alscjfdl33-pixel/biped_bike_runtime/meshes/base_link.STL

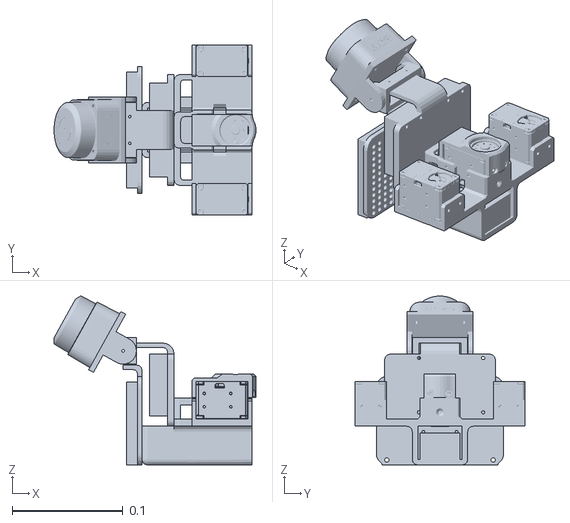
[picture p4: CAD file, 2026-08-25]
meshes/base_link.STL
0.182 x 0.154 x 0.152
