alscjfdl33-pixel/biped_bike_runtime/meshes/r_knee_pitch.STL

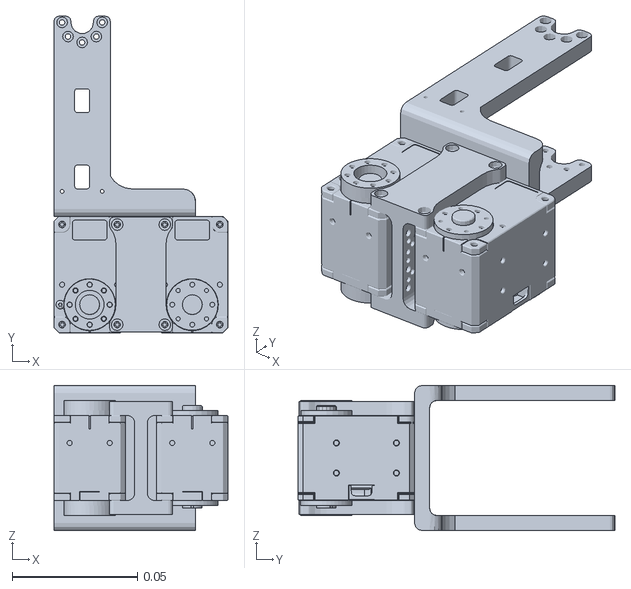
[picture p5: CAD file, 2026-08-25]
meshes/r_knee_pitch.STL
0.0695 x 0.126 x 0.058
