alscjfdl33-pixel/biped_bike_runtime/meshes/arm_wrist_roll.STL

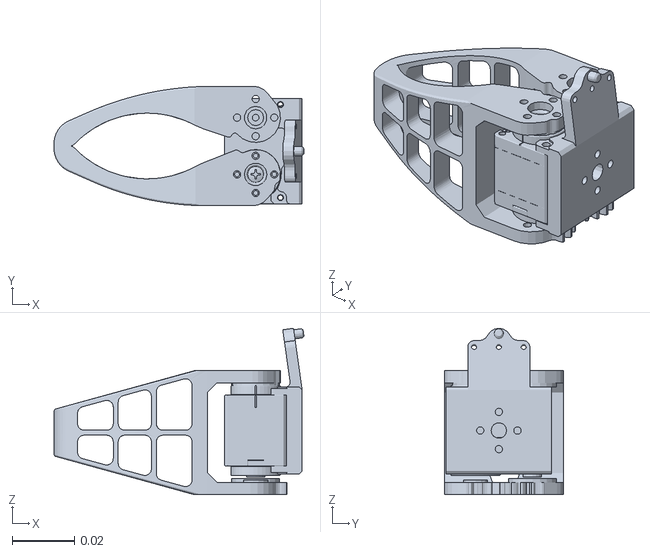
[picture p6: CAD file, 2026-08-25]
meshes/arm_wrist_roll.STL
0.0806 x 0.0385 x 0.0537
