alscjfdl33-pixel/biped_bike_runtime/meshes/l_ankle_pitch.STL

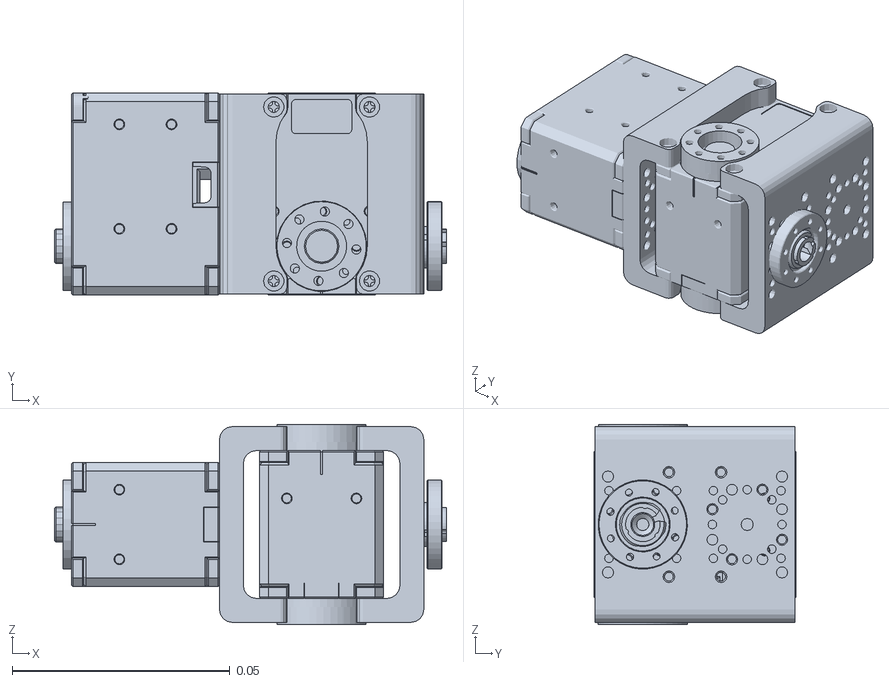
[picture p7: CAD file, 2026-08-25]
meshes/l_ankle_pitch.STL
0.0901 x 0.0465 x 0.046
