alscjfdl33-pixel/biped_bike_runtime/meshes/arm_elbow_pitch.STL

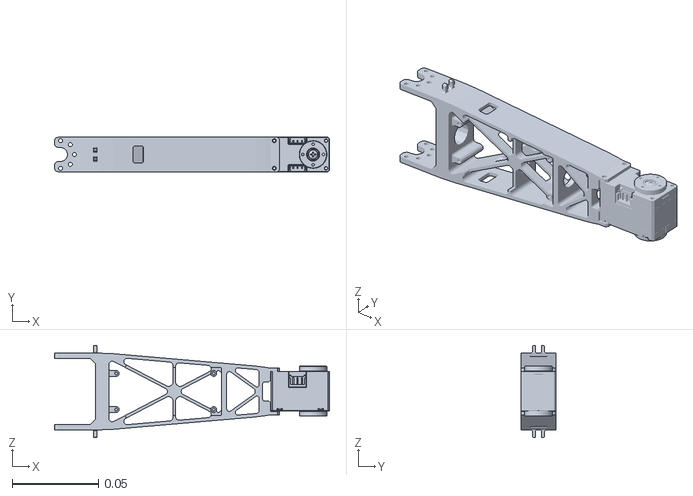
[picture p8: CAD file, 2026-08-25]
meshes/arm_elbow_pitch.STL
0.159 x 0.02 x 0.0535
