alscjfdl33-pixel/biped_bike_runtime/meshes/arm_base_yaw.STL

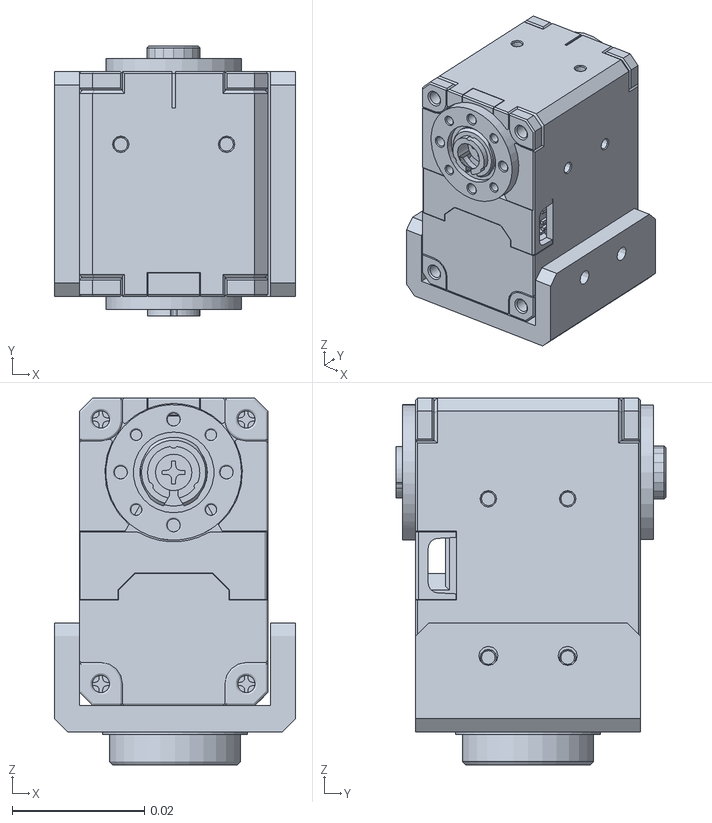
[picture p9: CAD file, 2026-08-25]
meshes/arm_base_yaw.STL
0.0365 x 0.0409 x 0.0555
