alscjfdl33-pixel/biped_bike_runtime/meshes/arm_wrist_pitch.STL

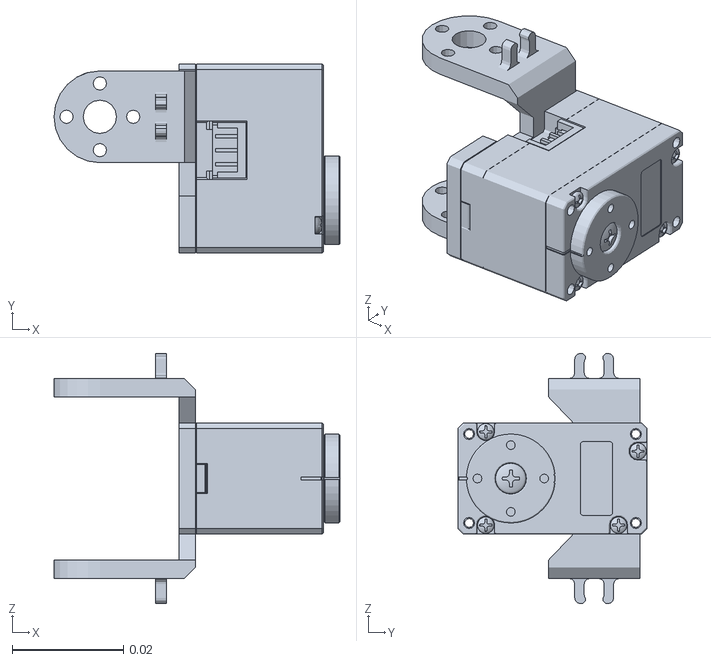
[picture p10: CAD file, 2026-08-25]
meshes/arm_wrist_pitch.STL
0.0515 x 0.034 x 0.045
