alscjfdl33-pixel/biped_bike_runtime/meshes/arm_shoulder_pitch.STL

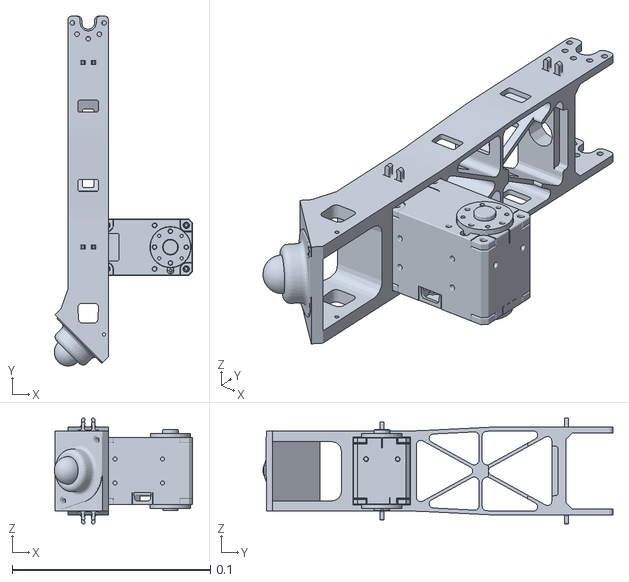
[picture p11: CAD file, 2026-08-25]
meshes/arm_shoulder_pitch.STL
0.0699 x 0.177 x 0.0535
