alscjfdl33-pixel/biped_bike_runtime/meshes/r_hip_yaw.STL

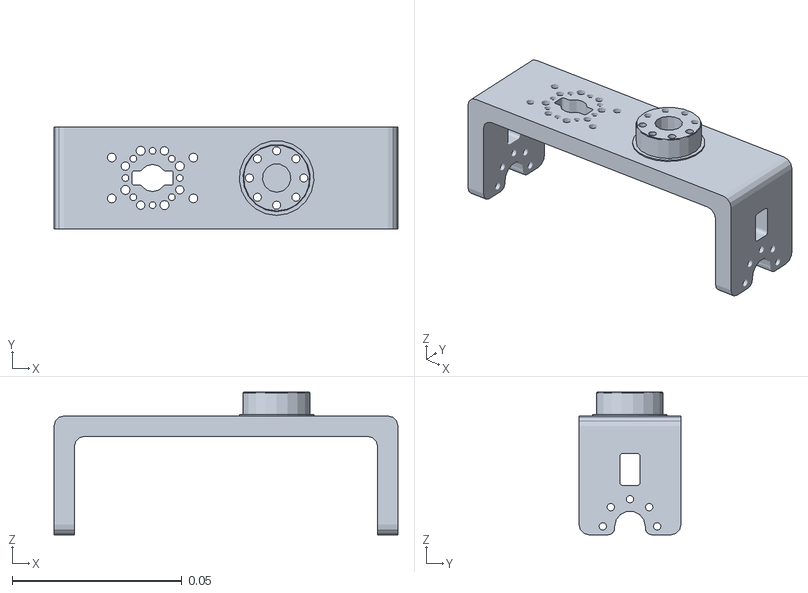
[picture p12: CAD file, 2026-08-25]
meshes/r_hip_yaw.STL
0.101 x 0.03 x 0.042
