alscjfdl33-pixel/biped_bike_runtime/meshes/l_hip_pitch.STL

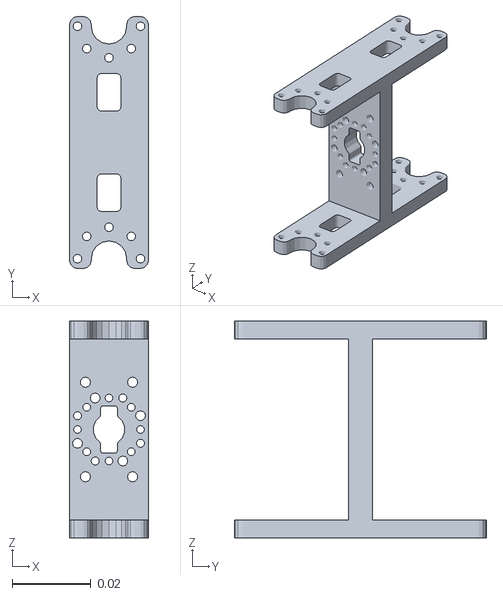
[picture p13: CAD file, 2026-08-25]
meshes/l_hip_pitch.STL
0.02 x 0.064 x 0.055
