alscjfdl33-pixel/biped_bike_runtime/meshes/r_foot_roll.STL

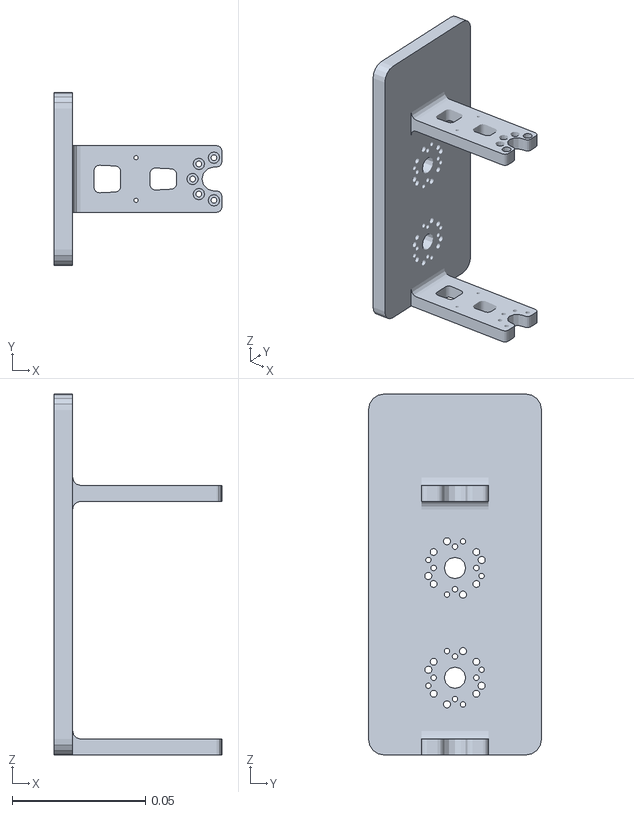
[picture p14: CAD file, 2026-08-25]
meshes/r_foot_roll.STL
0.063 x 0.065 x 0.135
