alscjfdl33-pixel/biped_bike_runtime/meshes/l_knee_pitch_wheel.STL

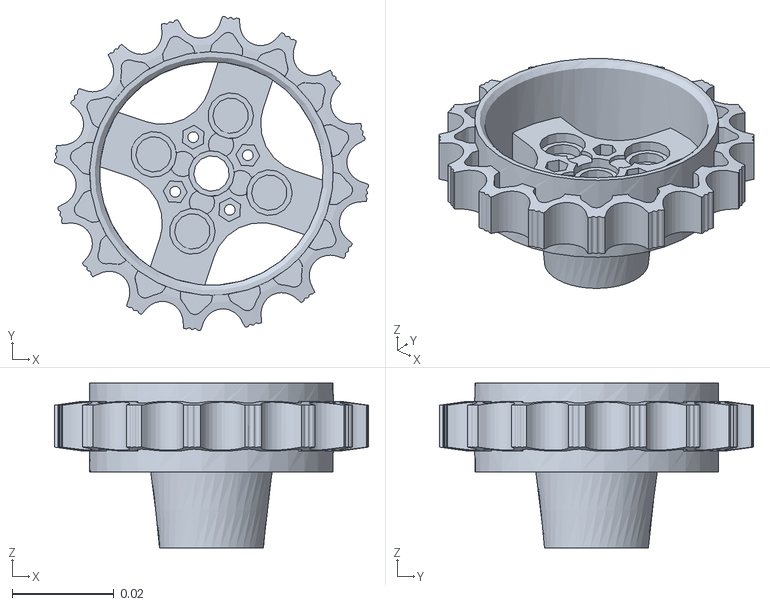
[picture p15: CAD file, 2026-08-25]
meshes/l_knee_pitch_wheel.STL
0.0619 x 0.0619 x 0.0325
