alscjfdl33-pixel/biped_bike_runtime/(list of files, cad)

Other CAD files:
meshes/r_hip_roll.STL
meshes/l_knee_pitch.STL
meshes/l_hip_roll.STL
meshes/r_ankle_pitch.STL
meshes/r_hip_pitch.STL
meshes/l_hip_yaw.STL
meshes/l_foot_roll.STL
meshes/r_knee_pitch_wheel.STL
solidworks_export/meshes/l_foot_roll.STL
solidworks_export/meshes/l_hip_roll.STL
solidworks_export/meshes/l_hip_yaw.STL
solidworks_export/meshes/l_knee_pitch.STL
solidworks_export/meshes/r_ankle_pitch.STL
solidworks_export/meshes/r_hip_pitch.STL
solidworks_export/meshes/r_hip_roll.STL
solidworks_export/meshes/r_knee_pitch_wheel.STL
