alscjfdl33-pixel/biped_bike_runtime/scripts/dxl_joint_state_bridge.py

#!/usr/bin/env python3
import csv
import datetime as dt
import math
import os
import struct
from typing import Dict, List, Optional, Tuple

import rclpy
import yaml
from ament_index_python.packages import get_package_share_directory
from rclpy.node import Node
from sensor_msgs.msg import Imu, JointState
from std_msgs.msg import Float64MultiArray
from trajectory_msgs.msg import JointTrajectory

try:
    from dynamixel_sdk import COMM_SUCCESS, GroupSyncRead, GroupSyncWrite, PacketHandler, PortHandler
except ImportError:
    COMM_SUCCESS = None
    GroupSyncRead = None
    GroupSyncWrite = None
    PacketHandler = None
    PortHandler = None


ADDR_OPERATING_MODE = 11
ADDR_PWM_LIMIT = 36
ADDR_TORQUE_ENABLE = 64
ADDR_HARDWARE_ERROR_STATUS = 70
ADDR_POSITION_D_GAIN = 80
ADDR_POSITION_I_GAIN = 82
ADDR_POSITION_P_GAIN = 84
ADDR_GOAL_VELOCITY = 104
ADDR_PROFILE_ACCELERATION = 108
ADDR_PROFILE_VELOCITY = 112
ADDR_GOAL_POSITION = 116
ADDR_PRESENT_PWM = 124
ADDR_PRESENT_LOAD = 126
ADDR_PRESENT_VELOCITY = 128
ADDR_PRESENT_POSITION = 132
ADDR_PRESENT_INPUT_VOLTAGE = 144
ADDR_PRESENT_TEMPERATURE = 146
LEN_GOAL_POSITION = 4
LEN_GOAL_VELOCITY = 4
LEN_TELEMETRY_BLOCK = 23
ADDR_OPENCR_IMU_BLOCK = 100
LEN_OPENCR_IMU_BLOCK = 68
STANDARD_GRAVITY = 9.80665
TORQUE_DISABLE = 0
TORQUE_ENABLE = 1
READY_HIP_PITCH_RAD = 0.0
READY_KNEE_PITCH_RAD = -0.30
READY_ANKLE_FORWARD_OFFSET_RAD = 0.174533
READY_ANKLE_PITCH_RAD = 0.15 + READY_ANKLE_FORWARD_OFFSET_RAD
HARDWARE_ERROR_BITS = {
    0: "input_voltage",
    2: "overheating",
    3: "motor_encoder",
    4: "electrical_shock",
    5: "overload",
}


Trajectory = List[Tuple[float, Dict[str, float]]]


def interpolate_trajectory(
    start_positions: Dict[str, float],
    trajectory: Trajectory,
    elapsed: float,
) -> Tuple[Dict[str, float], bool]:
    """Linearly sample a trajectory, using the current pose as the t=0 point."""
    if not trajectory:
        return dict(start_positions), True

    if elapsed >= trajectory[-1][0]:
        return dict(trajectory[-1][1]), True

    previous_time = 0.0
    previous_positions = start_positions
    for next_time, next_positions in trajectory:
        if elapsed <= next_time:
            duration = next_time - previous_time
            alpha = 1.0 if duration <= 0.0 else (elapsed - previous_time) / duration
            alpha = max(0.0, min(1.0, alpha))
            sampled = {
                name: previous_positions[name]
                + alpha * (next_positions[name] - previous_positions[name])
                for name in next_positions
            }
            return sampled, False
        previous_time = next_time
        previous_positions = next_positions

    return dict(trajectory[-1][1]), True


class MotorConfig:
    def __init__(self, data: dict, tick_per_rad: float):
        self.id = int(data["id"])
        self.joint_name = data["joint_name"]
        self.control_mode = data["control_mode"]
        self.operating_mode = int(data["operating_mode"])
        self.center_tick = int(data.get("center_tick", 2048))
        self.direction = int(data.get("direction", 1))
        self.active = bool(data.get("active", True))
        self.tick_per_rad = tick_per_rad
        self.min_position_rad = float(data.get("min_position_rad", -math.inf))
        self.max_position_rad = float(data.get("max_position_rad", math.inf))
        max_abs_position_rad = data.get("max_abs_position_rad")
        self.max_abs_position_rad = (
            None if max_abs_position_rad is None else float(max_abs_position_rad)
        )
        self.pwm_limit = data.get("pwm_limit")
        self.position_p_gain = data.get("position_p_gain")
        self.position_i_gain = data.get("position_i_gain")
        self.position_d_gain = data.get("position_d_gain")
        self.profile_acceleration = data.get("profile_acceleration")
        self.profile_velocity = data.get("profile_velocity")

    def position_to_tick(self, position_rad: float) -> int:
        tick = self.center_tick + self.direction * position_rad * self.tick_per_rad
        return int(round(max(0, min(4095, tick))))

    def tick_to_position(self, tick: int) -> float:
        return (tick - self.center_tick) / (self.direction * self.tick_per_rad)

    def position_in_range(self, position_rad: float) -> bool:
        return self.min_position_rad <= position_rad <= self.max_position_rad

    def command_abs_limit(self, default_limit: float) -> float:
        if self.max_abs_position_rad is not None:
            return self.max_abs_position_rad
        return default_limit

    def velocity_to_raw(self, velocity_rad_s: float, raw_per_rad_s: float) -> int:
        raw = round(self.direction * velocity_rad_s * raw_per_rad_s)
        return max(-(2**31), min(2**31 - 1, raw))


class DxlJointStateBridge(Node):
    def __init__(self):
        super().__init__("dxl_joint_state_bridge")

        self.declare_parameter("config_path", "")
        self.declare_parameter("torque_on_start", True)
        self.declare_parameter("torque_off_on_shutdown", True)
        self.declare_parameter("center_on_start", False)
        self.declare_parameter("startup_ready_posture_on_start", False)
        self.declare_parameter("startup_forward_lean_deg", 0.0)
        self.declare_parameter("startup_shoulder_pitch_deg", -70.0)
        self.declare_parameter("max_abs_position_rad", 0.35)
        self.declare_parameter("min_tick_change", 2)
        self.declare_parameter("log_joint_states", True)
        self.declare_parameter("enable_joint_state_commands", True)
        self.declare_parameter("enable_trajectory_commands", True)
        self.declare_parameter("enable_velocity_commands", True)
        self.declare_parameter(
            "trajectory_topic", "/joint_trajectory_controller/joint_trajectory"
        )
        self.declare_parameter(
            "velocity_topic", "/wheel_velocity_controller/commands"
        )
        self.declare_parameter("max_wheel_velocity_rad_s", 2.0)
        self.declare_parameter("wheel_command_timeout_sec", 0.5)
        self.declare_parameter("log_telemetry", False)
        self.declare_parameter("telemetry_log_path", "")
        self.declare_parameter("telemetry_rate_hz", 5.0)
        self.declare_parameter("telemetry_duration_sec", 10.0)
        self.declare_parameter("telemetry_motor_ids", "")
        self.declare_parameter("publish_present_joint_states", False)
        self.declare_parameter("present_joint_state_topic", "/joint_states")
        self.declare_parameter("present_joint_state_rate_hz", 15.0)
        self.declare_parameter("present_joint_state_motor_ids", "")
        self.declare_parameter("enable_opencr_imu", False)
        self.declare_parameter("opencr_imu_id", 200)
        self.declare_parameter("opencr_imu_topic", "/opencr/imu")
        self.declare_parameter("opencr_imu_frame_id", "body_link")
        self.declare_parameter("opencr_imu_rate_hz", 30.0)

        if PacketHandler is None or PortHandler is None:
            raise RuntimeError(
                "dynamixel_sdk is not installed. Install the ROS/Python Dynamixel SDK first."
            )

        config_path = self.get_parameter("config_path").get_parameter_value().string_value
        if not config_path:
            pkg_share = get_package_share_directory("biped_bike_runtime")
            config_path = os.path.join(pkg_share, "config", "dynamixel_hardware.yaml")

        self.config = self._load_config(config_path)
        self.port_handler = PortHandler(self.config["bus"]["device"])
        self.packet_handler = PacketHandler(float(self.config["bus"]["protocol_version"]))
        self.group_sync_write = GroupSyncWrite(
            self.port_handler,
            self.packet_handler,
            ADDR_GOAL_POSITION,
            LEN_GOAL_POSITION,
        )
        self.group_sync_write_velocity = GroupSyncWrite(
            self.port_handler,
            self.packet_handler,
            ADDR_GOAL_VELOCITY,
            LEN_GOAL_VELOCITY,
        )
        self.group_sync_read = None
        self.last_goal_ticks: Dict[int, int] = {}
        self.last_goal_velocities: Dict[int, int] = {}
        self.last_velocity_command_time = None
        self.velocity_watchdog_stopped = True
        self.received_joint_states = False
        self.active_trajectory: Trajectory = []
        self.trajectory_start_positions: Dict[str, float] = {}
        self.trajectory_start_time = None
        self.telemetry_file = None
        self.telemetry_writer = None
        self.telemetry_start_time = None
        self.telemetry_duration_sec = 0.0
        self.telemetry_motors = []
        self.opencr_imu_warned = False
        self._destroying = False

        self.max_abs_position_rad = (
            self.get_parameter("max_abs_position_rad").get_parameter_value().double_value
        )
        self.min_tick_change = (
            self.get_parameter("min_tick_change").get_parameter_value().integer_value
        )
        self.max_wheel_velocity_rad_s = float(
            self.get_parameter("max_wheel_velocity_rad_s").value
        )
        self.wheel_command_timeout_sec = float(
            self.get_parameter("wheel_command_timeout_sec").value
        )
        self.velocity_raw_per_rad_s = float(
            self.config["conversion"]["velocity_raw_per_rad_per_sec"]
        )

        self.all_motors = self._load_active_motors()
        self.position_motors = [
            motor for motor in self.all_motors if motor.control_mode == "position"
        ]
        self.velocity_motors = [
            motor for motor in self.all_motors if motor.control_mode == "velocity"
        ]
        self.joint_to_motor = {motor.joint_name: motor for motor in self.position_motors}

        self._open_bus()
        self._configure_motors(
            torque_on_start=self.get_parameter("torque_on_start").value
        )
        if self.get_parameter("center_on_start").value:
            self._center_position_motors()
        if self.get_parameter("startup_ready_posture_on_start").value:
            self._send_startup_ready_posture()

        publish_present_joint_states = bool(
            self.get_parameter("publish_present_joint_states").value
        )
        present_joint_state_topic = self.get_parameter("present_joint_state_topic").value
        if publish_present_joint_states:
            self._setup_present_joint_state_publisher(present_joint_state_topic)

        joint_state_commands_enabled = bool(
            self.get_parameter("enable_joint_state_commands").value
        )
        if publish_present_joint_states and present_joint_state_topic == "/joint_states":
            joint_state_commands_enabled = False
            self.get_logger().warn(
                "Disabled /joint_states command subscription because present "
                "hardware joint states are being published on /joint_states"
            )

        if joint_state_commands_enabled:
            self.subscription = self.create_subscription(
                JointState,
                "/joint_states",
                self.joint_state_callback,
                10,
            )

        if self.get_parameter("enable_trajectory_commands").value:
            trajectory_topic = (
                self.get_parameter("trajectory_topic").get_parameter_value().string_value
            )
            self.trajectory_subscription = self.create_subscription(
                JointTrajectory,
                trajectory_topic,
                self.trajectory_callback,
                10,
            )
            self.trajectory_timer = self.create_timer(0.008, self.trajectory_timer_callback)

        if self.get_parameter("enable_velocity_commands").value:
            velocity_topic = self.get_parameter("velocity_topic").value
            self.velocity_subscription = self.create_subscription(
                Float64MultiArray,
                velocity_topic,
                self.velocity_command_callback,
                10,
            )
            self.velocity_watchdog_timer = self.create_timer(
                0.1,
                self.velocity_watchdog_callback,
            )

        if self.get_parameter("log_telemetry").value:
            self._setup_telemetry_logger()

        if self.get_parameter("enable_opencr_imu").value:
            self._setup_opencr_imu()

        names = ", ".join(m.joint_name for m in self.position_motors)
        self.get_logger().info(f"Configured Dynamixel position motors: {names}")

    def destroy_node(self):
        if self._destroying:
            return
        self._destroying = True

        # Stop callbacks before touching the serial port. If Ctrl+C interrupts a
        # Dynamixel SDK read, its internal is_using flag can otherwise remain set
        # and prevent the emergency wheel-stop / torque-off writes below.
        for timer_name in (
            "present_joint_state_timer",
            "trajectory_timer",
            "velocity_watchdog_timer",
            "telemetry_timer",
            "opencr_imu_timer",
        ):
            timer = getattr(self, timer_name, None)
            if timer is not None:
                timer.cancel()

        if hasattr(self, "port_handler") and self.port_handler.is_using:
            # Do not call clearPort() here. Its pyserial flush may block in
            # tcdrain after an interrupted USB transaction and prevent the
            # emergency wheel-stop / torque-off sequence from running.
            self.port_handler.is_using = False

        try:
            if self.velocity_motors:
                self._sync_write_goal_velocities(
                    {motor: 0 for motor in self.velocity_motors}
                )
            if self.get_parameter("torque_off_on_shutdown").value:
                for motor in self.all_motors:
                    self._write1(motor.id, ADDR_TORQUE_ENABLE, TORQUE_DISABLE)
                self.get_logger().warn("Disabled Dynamixel torque on shutdown")
            else:
                self.get_logger().warn(
                    "Keeping Dynamixel torque enabled on shutdown; wheels commanded to zero"
                )
        finally:
            if self.telemetry_file is not None:
                self.telemetry_file.close()
            if hasattr(self, "port_handler"):
                self.port_handler.closePort()
        super().destroy_node()

    def _load_config(self, config_path: str) -> dict:
        with open(config_path, "r", encoding="utf-8") as stream:
            config = yaml.safe_load(stream)
        self.get_logger().info(f"Loaded Dynamixel config: {config_path}")
        return config

    def _load_active_motors(self) -> List[MotorConfig]:
        tick_per_rad = float(self.config["conversion"]["tick_per_rad"])
        defaults = self.config.get("defaults", {})
        motors = []
        for joint in self.config["joints"]:
            if not joint.get("active", True):
                continue
            for key in (
                "pwm_limit",
                "position_p_gain",
                "position_i_gain",
                "position_d_gain",
                "profile_acceleration",
                "profile_velocity",
            ):
                if key not in joint:
                    joint[key] = defaults.get(key)
            motors.append(MotorConfig(joint, tick_per_rad))
        return motors

    def _open_bus(self):
        device = self.config["bus"]["device"]
        baudrate = int(self.config["bus"]["baudrate"])
        if not self.port_handler.openPort():
            raise RuntimeError(f"Failed to open Dynamixel port: {device}")
        if not self.port_handler.setBaudRate(baudrate):
            raise RuntimeError(f"Failed to set Dynamixel baudrate: {baudrate}")
        self.get_logger().info(f"Opened Dynamixel bus {device} @ {baudrate}")

    def _configure_motors(self, torque_on_start: bool):
        for motor in self.all_motors:
            self._write1(motor.id, ADDR_TORQUE_ENABLE, TORQUE_DISABLE)
            self._write1(motor.id, ADDR_OPERATING_MODE, motor.operating_mode)
            self._apply_motor_tuning(motor)
            if motor.control_mode == "velocity":
                self._write4(motor.id, ADDR_GOAL_VELOCITY, 0)
            if torque_on_start:
                self._write1(motor.id, ADDR_TORQUE_ENABLE, TORQUE_ENABLE)
        torque_state = "enabled" if torque_on_start else "disabled"
        self.get_logger().info(
            f"Configured {len(self.position_motors)} position and "
            f"{len(self.velocity_motors)} velocity motors, torque {torque_state}"
        )

    def _apply_motor_tuning(self, motor: MotorConfig):
        writes_2byte = (
            ("pwm_limit", ADDR_PWM_LIMIT, motor.pwm_limit),
            ("position_d_gain", ADDR_POSITION_D_GAIN, motor.position_d_gain),
            ("position_i_gain", ADDR_POSITION_I_GAIN, motor.position_i_gain),
            ("position_p_gain", ADDR_POSITION_P_GAIN, motor.position_p_gain),
        )
        writes_4byte = (
            ("profile_acceleration", ADDR_PROFILE_ACCELERATION, motor.profile_acceleration),
            ("profile_velocity", ADDR_PROFILE_VELOCITY, motor.profile_velocity),
        )

        applied = []
        for name, address, value in writes_2byte:
            if value is None:
                continue
            self._write2(motor.id, address, int(value))
            applied.append(f"{name}={int(value)}")

        for name, address, value in writes_4byte:
            if value is None:
                continue
            self._write4(motor.id, address, int(value))
            applied.append(f"{name}={int(value)}")

        if applied:
            self.get_logger().info(
                f"DXL {motor.id} {motor.joint_name} tuning: {', '.join(applied)}"
            )

    def _center_position_motors(self):
        self.get_logger().warn(
            "center_on_start is true: sending center tick to all position motors"
        )
        self._sync_write_goal_ticks(
            {motor: motor.center_tick for motor in self.position_motors}
        )
        self.get_logger().info("Sent center ticks to all position motors")

    def _send_startup_ready_posture(self):
        shoulder_pitch = math.radians(
            float(self.get_parameter("startup_shoulder_pitch_deg").value)
        )
        ready_positions = {
            "l_hip_yaw_jnt": 0.0,
            "l_hip_roll_jnt": 0.0,
            "l_hip_pitch_jnt": -READY_HIP_PITCH_RAD,
            "l_knee_pitch_jnt": READY_KNEE_PITCH_RAD,
            "l_ankle_pitch_jnt": READY_ANKLE_PITCH_RAD,
            "l_foot_roll_jnt": 0.0,
            "r_hip_yaw_jnt": 0.0,
            "r_hip_roll_jnt": 0.0,
            "r_hip_pitch_jnt": READY_HIP_PITCH_RAD,
            "r_knee_pitch_jnt": READY_KNEE_PITCH_RAD,
            "r_ankle_pitch_jnt": READY_ANKLE_PITCH_RAD,
            "r_foot_roll_jnt": 0.0,
            "arm_base_yaw_jnt": 0.0,
            "arm_shoulder_pitch_jnt": shoulder_pitch,
            "arm_elbow_pitch_jnt": 0.0,
            "arm_wrist_pitch_jnt": 0.0,
            "arm_wrist_roll_jnt": 0.0,
        }
        command_positions = {
            motor.joint_name: ready_positions[motor.joint_name]
            for motor in self.position_motors
            if motor.joint_name in ready_positions
        }
        self.get_logger().warn(
            "startup_ready_posture_on_start is true: sending forward-lean ready posture"
        )
        self._send_position_map(command_positions, source="startup_ready")

    def joint_state_callback(self, msg: JointState):
        if not self.received_joint_states:
            self.received_joint_states = True
            matched = [name for name in msg.name if name in self.joint_to_motor]
            self.get_logger().info(
                f"Received /joint_states with {len(msg.name)} joints; "
                f"{len(matched)} mapped to Dynamixel motors"
            )

        for joint_name, position in zip(msg.name, msg.position):
            motor = self.joint_to_motor.get(joint_name)
            if motor is None:
                continue

            if not math.isfinite(position):
                continue
            command_limit = motor.command_abs_limit(self.max_abs_position_rad)
            if abs(position) > command_limit:
                self.get_logger().warn(
                    f"Skip {joint_name}: {position:.3f} rad exceeds "
                    f"command limit={command_limit:.3f} rad",
                    throttle_duration_sec=1.0,
                )
                continue
            if not motor.position_in_range(position):
                self.get_logger().warn(
                    f"Skip {joint_name}: {position:.3f} rad outside mechanical "
                    f"range [{motor.min_position_rad:.3f}, {motor.max_position_rad:.3f}]",
                    throttle_duration_sec=1.0,
                )
                continue

            goal_tick = motor.position_to_tick(position)
            prev_tick = self.last_goal_ticks.get(motor.id)
            if prev_tick is not None and abs(goal_tick - prev_tick) < self.min_tick_change:
                continue

            self._write_goal_tick(motor, goal_tick)
            if self.get_parameter("log_joint_states").value:
                self.get_logger().info(
                    f"{joint_name} -> ID {motor.id}: {position:.4f} rad, tick {goal_tick}",
                    throttle_duration_sec=0.5,
                )

    def trajectory_callback(self, msg: JointTrajectory):
        trajectory: Trajectory = []
        mapped_names = [name for name in msg.joint_names if name in self.joint_to_motor]
        commanded_names = []
        previous_time = -1.0

        for point in msg.points:
            positions = {}
            for joint_name, position in zip(msg.joint_names, point.positions):
                if joint_name in self.joint_to_motor:
                    positions[joint_name] = position

            if not positions:
                continue

            time_from_start = point.time_from_start.sec + (
                point.time_from_start.nanosec * 1e-9
            )
            if time_from_start < previous_time:
                self.get_logger().error(
                    "Rejected trajectory: time_from_start must be nondecreasing"
                )
                return
            trajectory.append((time_from_start, positions))
            previous_time = time_from_start
            for joint_name in positions:
                if joint_name not in commanded_names:
                    commanded_names.append(joint_name)

        if not trajectory:
            self.get_logger().warn("Ignored trajectory with no executable points")
            return

        start_positions = self._read_current_positions(commanded_names)
        carried_positions = dict(start_positions)
        normalized_trajectory: Trajectory = []
        for time_from_start, positions in trajectory:
            carried_positions.update(positions)
            normalized_trajectory.append((time_from_start, dict(carried_positions)))

        self.active_trajectory = normalized_trajectory
        self.trajectory_start_positions = start_positions
        self.trajectory_start_time = self.get_clock().now()
        self.get_logger().warn(
            f"Received trajectory: {len(msg.points)} points, "
            f"{len(mapped_names)} mapped joints, {len(trajectory)} executable points; "
            "linear interpolation enabled"
        )

    def trajectory_timer_callback(self):
        if not self.active_trajectory or self.trajectory_start_time is None:
            return

        elapsed = (
            self.get_clock().now() - self.trajectory_start_time
        ).nanoseconds * 1e-9

        positions, finished = interpolate_trajectory(
            self.trajectory_start_positions,
            self.active_trajectory,
            elapsed,
        )
        self._send_position_map(positions, source="trajectory")

        if finished:
            self.active_trajectory = []
            self.trajectory_start_positions = {}
            self.trajectory_start_time = None
            self.get_logger().info("Finished trajectory playback")

    def velocity_command_callback(self, msg: Float64MultiArray):
        if len(msg.data) < len(self.velocity_motors):
            self.get_logger().error(
                f"Wheel command has {len(msg.data)} values, but "
                f"{len(self.velocity_motors)} velocity motors are configured"
            )
            return

        goal_velocities = {}
        clamped = False
        for motor, requested_velocity in zip(self.velocity_motors, msg.data):
            velocity = float(requested_velocity)
            if not math.isfinite(velocity):
                velocity = 0.0
            limited_velocity = max(
                -self.max_wheel_velocity_rad_s,
                min(self.max_wheel_velocity_rad_s, velocity),
            )
            clamped = clamped or limited_velocity != velocity
            goal_velocities[motor] = motor.velocity_to_raw(
                limited_velocity,
                self.velocity_raw_per_rad_s,
            )

        self._sync_write_goal_velocities(goal_velocities)
        self.last_velocity_command_time = self.get_clock().now()
        self.velocity_watchdog_stopped = all(
            raw_velocity == 0 for raw_velocity in goal_velocities.values()
        )
        if clamped:
            self.get_logger().warn(
                f"Clamped wheel command to ±{self.max_wheel_velocity_rad_s:.2f} rad/s",
                throttle_duration_sec=1.0,
            )

    def velocity_watchdog_callback(self):
        if self.last_velocity_command_time is None or self.velocity_watchdog_stopped:
            return
        elapsed = (
            self.get_clock().now() - self.last_velocity_command_time
        ).nanoseconds * 1e-9
        if elapsed <= self.wheel_command_timeout_sec:
            return

        self._sync_write_goal_velocities(
            {motor: 0 for motor in self.velocity_motors}
        )
        self.velocity_watchdog_stopped = True
        self.get_logger().warn(
            f"Wheel command timeout after {elapsed:.2f}s; stopped all wheels"
        )

    def _read_current_positions(self, joint_names: List[str]) -> Dict[str, float]:
        positions = {}
        for joint_name in joint_names:
            motor = self.joint_to_motor[joint_name]
            tick = self._read_present_position_tick(motor)
            if tick is None:
                tick = self.last_goal_ticks.get(motor.id, motor.center_tick)
                self.get_logger().warn(
                    f"Using last goal as interpolation start for {joint_name}",
                    throttle_duration_sec=1.0,
                )
            positions[joint_name] = motor.tick_to_position(tick)
        return positions

    def _read_present_position_tick(self, motor: MotorConfig) -> Optional[int]:
        tick, result, error = self.packet_handler.read4ByteTxRx(
            self.port_handler,
            motor.id,
            ADDR_PRESENT_POSITION,
        )
        if result != COMM_SUCCESS:
            self.get_logger().error(
                f"DXL {motor.id} position read failed: "
                f"{self.packet_handler.getTxRxResult(result)}"
            )
            return None
        if error != 0:
            self.get_logger().error(
                f"DXL {motor.id} position packet error: "
                f"{self.packet_handler.getRxPacketError(error)}"
            )
            return None
        return int(tick)

    def _setup_present_joint_state_publisher(self, topic: str):
        motor_ids_text = str(
            self.get_parameter("present_joint_state_motor_ids").value
        ).strip()
        if motor_ids_text:
            try:
                selected_ids = {
                    int(value.strip())
                    for value in motor_ids_text.split(",")
                    if value.strip()
                }
            except ValueError as exc:
                raise ValueError(
                    "present_joint_state_motor_ids must be comma-separated integers"
                ) from exc
            self.present_joint_state_motors = [
                motor for motor in self.all_motors if motor.id in selected_ids
            ]
            missing_ids = selected_ids.difference(
                motor.id for motor in self.present_joint_state_motors
            )
            if missing_ids:
                self.get_logger().warn(
                    "Ignoring unknown/inactive present-state motor IDs: "
                    + ", ".join(str(value) for value in sorted(missing_ids))
                )
            if not self.present_joint_state_motors:
                raise ValueError(
                    "present_joint_state_motor_ids selected no active motors"
                )
        else:
            self.present_joint_state_motors = list(self.all_motors)

        self.present_joint_state_pub = self.create_publisher(JointState, topic, 10)
        rate_hz = max(
            1.0,
            float(self.get_parameter("present_joint_state_rate_hz").value),
        )
        self.present_joint_state_timer = self.create_timer(
            1.0 / rate_hz,
            self.present_joint_state_callback,
        )
        self.get_logger().warn(
            f"Publishing {len(self.present_joint_state_motors)} present Dynamixel "
            f"joint states to {topic} at {rate_hz:.1f} Hz: "
            + ", ".join(motor.joint_name for motor in self.present_joint_state_motors)
        )

    def present_joint_state_callback(self):
        msg = JointState()
        msg.header.stamp = self.get_clock().now().to_msg()

        for motor in self.present_joint_state_motors:
            tick = self._read_present_position_tick(motor)
            if tick is None:
                # Odometry requires a synchronized left/right wheel pair.
                # Publishing a partial sample would make the consumer pair
                # values from different instants or repeatedly report missing
                # wheel joints, so discard the whole sample instead.
                return
            msg.name.append(motor.joint_name)
            msg.position.append(motor.tick_to_position(tick))
            msg.velocity.append(0.0)
            msg.effort.append(0.0)

        if len(msg.name) == len(self.present_joint_state_motors):
            self.present_joint_state_pub.publish(msg)

    def _setup_telemetry_logger(self):
        if GroupSyncRead is None:
            raise RuntimeError(
                "dynamixel_sdk GroupSyncRead is unavailable; cannot log telemetry."
            )

        log_path = self.get_parameter("telemetry_log_path").get_parameter_value().string_value
        if not log_path:
            stamp = dt.datetime.now().strftime("%Y%m%d_%H%M%S")
            log_path = os.path.join(
                os.getcwd(),
                "src",
                "biped_bike_runtime",
                "motor_logs",
                f"dxl_telemetry_{stamp}.csv",
            )

        os.makedirs(os.path.dirname(os.path.abspath(log_path)), exist_ok=True)
        self.telemetry_file = open(log_path, "w", newline="", encoding="utf-8")
        self.telemetry_writer = csv.writer(self.telemetry_file)
        self.telemetry_writer.writerow(
            [
                "time_sec",
                "id",
                "joint_name",
                "control_mode",
                "goal_tick",
                "present_position_tick",
                "position_error_tick",
                "present_velocity_raw",
                "present_pwm_raw",
                "present_pwm_percent",
                "present_load_raw",
                "present_load_percent",
                "voltage_v",
                "temperature_c",
                "hardware_error_status",
                "hardware_error_flags",
            ]
        )
        self.telemetry_file.flush()

        motor_ids_text = (
            self.get_parameter("telemetry_motor_ids").get_parameter_value().string_value
        )
        if motor_ids_text.strip():
            wanted_ids = {
                int(item.strip())
                for item in motor_ids_text.split(",")
                if item.strip()
            }
            self.telemetry_motors = [
                motor for motor in self.all_motors if motor.id in wanted_ids
            ]
        else:
            self.telemetry_motors = list(self.all_motors)

        self.group_sync_read = GroupSyncRead(
            self.port_handler,
            self.packet_handler,
            ADDR_PRESENT_PWM,
            LEN_TELEMETRY_BLOCK,
        )
        for motor in self.telemetry_motors:
            if not self.group_sync_read.addParam(motor.id):
                self.get_logger().error(f"Failed to add DXL {motor.id} to telemetry sync read")

        rate_hz = self.get_parameter("telemetry_rate_hz").get_parameter_value().double_value
        rate_hz = max(1.0, rate_hz)
        self.telemetry_duration_sec = (
            self.get_parameter("telemetry_duration_sec").get_parameter_value().double_value
        )
        self.telemetry_start_time = self.get_clock().now()
        self.telemetry_timer = self.create_timer(1.0 / rate_hz, self.telemetry_callback)
        duration_text = (
            "until shutdown"
            if self.telemetry_duration_sec <= 0.0
            else f"for {self.telemetry_duration_sec:.1f}s"
        )
        self.get_logger().warn(
            f"Logging Dynamixel telemetry for {len(self.telemetry_motors)} motors "
            f"at {rate_hz:.1f} Hz {duration_text}: {log_path}"
        )

    def telemetry_callback(self):
        if self.group_sync_read is None or self.telemetry_writer is None:
            return

        now = self.get_clock().now()
        time_sec = (now - self.telemetry_start_time).nanoseconds * 1e-9
        if self.telemetry_duration_sec > 0.0 and time_sec > self.telemetry_duration_sec:
            self._stop_telemetry_logger()
            return

        result = self.group_sync_read.txRxPacket()
        if result != COMM_SUCCESS:
            self.get_logger().warn(
                f"Telemetry sync read failed: {self.packet_handler.getTxRxResult(result)}",
                throttle_duration_sec=1.0,
            )
            return

        for motor in self.telemetry_motors:
            if not self.group_sync_read.isAvailable(
                motor.id, ADDR_PRESENT_PWM, LEN_TELEMETRY_BLOCK
            ):
                self.get_logger().warn(
                    f"Telemetry unavailable for DXL {motor.id}",
                    throttle_duration_sec=1.0,
                )
                continue

            present_pwm = self._sync_read_signed(motor.id, ADDR_PRESENT_PWM, 2)
            present_load = self._sync_read_signed(motor.id, ADDR_PRESENT_LOAD, 2)
            present_velocity = self._sync_read_signed(motor.id, ADDR_PRESENT_VELOCITY, 4)
            present_position = self._sync_read_signed(motor.id, ADDR_PRESENT_POSITION, 4)
            voltage_raw = self.group_sync_read.getData(
                motor.id, ADDR_PRESENT_INPUT_VOLTAGE, 2
            )
            temperature = self.group_sync_read.getData(
                motor.id, ADDR_PRESENT_TEMPERATURE, 1
            )
            hardware_error_status = self._read_hardware_error_status(motor.id)
            hardware_error_flags = self._format_hardware_error_flags(
                hardware_error_status
            )
            if hardware_error_status:
                self.get_logger().error(
                    f"DXL {motor.id} {motor.joint_name} hardware error "
                    f"{hardware_error_status}: {hardware_error_flags}",
                    throttle_duration_sec=1.0,
                )

            goal_tick = self.last_goal_ticks.get(motor.id, "")
            position_error = ""
            if isinstance(goal_tick, int):
                position_error = goal_tick - present_position

            self.telemetry_writer.writerow(
                [
                    f"{time_sec:.4f}",
                    motor.id,
                    motor.joint_name,
                    motor.control_mode,
                    goal_tick,
                    present_position,
                    position_error,
                    present_velocity,
                    present_pwm,
                    f"{present_pwm * 0.113:.3f}",
                    present_load,
                    f"{present_load * 0.1:.3f}",
                    f"{voltage_raw * 0.1:.2f}",
                    temperature,
                    hardware_error_status,
                    hardware_error_flags,
                ]
            )
        self.telemetry_file.flush()

    def _stop_telemetry_logger(self):
        if hasattr(self, "telemetry_timer"):
            self.telemetry_timer.cancel()
        if self.telemetry_file is not None:
            self.telemetry_file.flush()
            self.telemetry_file.close()
            self.telemetry_file = None
        self.telemetry_writer = None
        self.group_sync_read = None
        self.get_logger().info("Stopped Dynamixel telemetry logging")

    def _setup_opencr_imu(self):
        self.opencr_imu_id = int(self.get_parameter("opencr_imu_id").value)
        self.opencr_imu_frame_id = self.get_parameter("opencr_imu_frame_id").value
        topic = self.get_parameter("opencr_imu_topic").value
        self.opencr_imu_pub = self.create_publisher(Imu, topic, 10)
        rate_hz = max(1.0, float(self.get_parameter("opencr_imu_rate_hz").value))
        self.opencr_imu_timer = self.create_timer(
            1.0 / rate_hz,
            self.opencr_imu_callback,
        )
        self.get_logger().warn(
            f"OpenCR IMU enabled: reading virtual DXL ID {self.opencr_imu_id} "
            f"at {rate_hz:.1f} Hz and publishing {topic}"
        )

    def opencr_imu_callback(self):
        data, result, error = self.packet_handler.readTxRx(
            self.port_handler,
            self.opencr_imu_id,
            ADDR_OPENCR_IMU_BLOCK,
            LEN_OPENCR_IMU_BLOCK,
        )
        if result != COMM_SUCCESS or error != 0 or len(data) != LEN_OPENCR_IMU_BLOCK:
            if not self.opencr_imu_warned:
                result_text = (
                    self.packet_handler.getTxRxResult(result)
                    if result != COMM_SUCCESS
                    else self.packet_handler.getRxPacketError(error)
                )
                self.get_logger().warn(
                    "OpenCR IMU read failed. Upload "
                    "arduino/opencr_dxl_bridge_with_imu/opencr_dxl_bridge_with_imu.ino "
                    f"and keep enable_opencr_imu:=true. Detail: {result_text}"
                )
                self.opencr_imu_warned = True
            return

        (
            _time_ms,
            qw,
            qx,
            qy,
            qz,
            _roll_deg,
            _pitch_deg,
            _yaw_deg,
            gyro_x_dps,
            gyro_y_dps,
            gyro_z_dps,
            acc_x_g,
            acc_y_g,
            acc_z_g,
            _gyro_x_adc,
            _gyro_y_adc,
            _gyro_z_adc,
            _acc_x_adc,
            _acc_y_adc,
            _acc_z_adc,
        ) = struct.unpack("<I13f6h", bytes(data))

        msg = Imu()
        msg.header.stamp = self.get_clock().now().to_msg()
        msg.header.frame_id = self.opencr_imu_frame_id
        msg.orientation.w = float(qw)
        msg.orientation.x = float(qx)
        msg.orientation.y = float(qy)
        msg.orientation.z = float(qz)
        msg.orientation_covariance[0] = 0.0025
        msg.orientation_covariance[4] = 0.0025
        msg.orientation_covariance[8] = 0.0025

        deg_to_rad = math.pi / 180.0
        msg.angular_velocity.x = float(gyro_x_dps) * deg_to_rad
        msg.angular_velocity.y = float(gyro_y_dps) * deg_to_rad
        msg.angular_velocity.z = float(gyro_z_dps) * deg_to_rad
        msg.angular_velocity_covariance[0] = 0.02
        msg.angular_velocity_covariance[4] = 0.02
        msg.angular_velocity_covariance[8] = 0.02

        msg.linear_acceleration.x = float(acc_x_g) * STANDARD_GRAVITY
        msg.linear_acceleration.y = float(acc_y_g) * STANDARD_GRAVITY
        msg.linear_acceleration.z = float(acc_z_g) * STANDARD_GRAVITY
        msg.linear_acceleration_covariance[0] = 0.04
        msg.linear_acceleration_covariance[4] = 0.04
        msg.linear_acceleration_covariance[8] = 0.04

        self.opencr_imu_pub.publish(msg)
        self.opencr_imu_warned = False

    def _sync_read_signed(self, dxl_id: int, address: int, length: int) -> int:
        value = self.group_sync_read.getData(dxl_id, address, length)
        bits = length * 8
        sign_bit = 1 << (bits - 1)
        if value & sign_bit:
            value -= 1 << bits
        return value

    def _read_hardware_error_status(self, dxl_id: int) -> int:
        value, result, error = self.packet_handler.read1ByteTxRx(
            self.port_handler,
            dxl_id,
            ADDR_HARDWARE_ERROR_STATUS,
        )
        if result != COMM_SUCCESS or error != 0:
            return -1
        return int(value)

    @staticmethod
    def _format_hardware_error_flags(status: int) -> str:
        if status == 0:
            return ""
        if status < 0:
            return "read_failed"
        flags = [
            name for bit, name in HARDWARE_ERROR_BITS.items() if status & (1 << bit)
        ]
        return "|".join(flags) if flags else f"unknown_bits_{status}"

    def _send_position_map(self, positions: Dict[str, float], source: str):
        goal_ticks = {}
        global_limit_skipped = 0

        for joint_name, position in positions.items():
            motor = self.joint_to_motor.get(joint_name)
            if motor is None or not math.isfinite(position):
                continue
            command_limit = motor.command_abs_limit(self.max_abs_position_rad)
            if abs(position) > command_limit:
                global_limit_skipped += 1
                continue
            if not motor.position_in_range(position):
                self.get_logger().warn(
                    f"Skipped {source} command for {joint_name}: {position:.3f} rad "
                    f"outside mechanical range "
                    f"[{motor.min_position_rad:.3f}, {motor.max_position_rad:.3f}]",
                    throttle_duration_sec=1.0,
                )
                continue

            goal_tick = motor.position_to_tick(position)
            prev_tick = self.last_goal_ticks.get(motor.id)
            if prev_tick is not None and abs(goal_tick - prev_tick) < self.min_tick_change:
                continue
            goal_ticks[motor] = goal_tick

        if global_limit_skipped > 0:
            self.get_logger().warn(
                f"Skipped {global_limit_skipped} {source} joints over "
                "their absolute command limits",
                throttle_duration_sec=1.0,
            )

        if goal_ticks:
            self._sync_write_goal_ticks(goal_ticks)

    def _write_goal_tick(self, motor: MotorConfig, goal_tick: int):
        self._write4(motor.id, ADDR_GOAL_POSITION, goal_tick)
        self.last_goal_ticks[motor.id] = goal_tick

    def _sync_write_goal_ticks(self, goal_ticks: Dict[MotorConfig, int]):
        self.group_sync_write.clearParam()

        for motor, goal_tick in goal_ticks.items():
            param = int(goal_tick).to_bytes(4, byteorder="little", signed=False)
            if not self.group_sync_write.addParam(motor.id, list(param)):
                self.get_logger().error(f"Failed to add DXL {motor.id} to sync write")

        result = self.group_sync_write.txPacket()
        if result != COMM_SUCCESS:
            self.get_logger().error(
                f"Sync write failed: {self.packet_handler.getTxRxResult(result)}"
            )
            return

        for motor, goal_tick in goal_ticks.items():
            self.last_goal_ticks[motor.id] = goal_tick

    def _sync_write_goal_velocities(self, goal_velocities: Dict[MotorConfig, int]):
        self.group_sync_write_velocity.clearParam()

        for motor, goal_velocity in goal_velocities.items():
            param = int(goal_velocity).to_bytes(4, byteorder="little", signed=True)
            if not self.group_sync_write_velocity.addParam(motor.id, list(param)):
                self.get_logger().error(
                    f"Failed to add DXL {motor.id} to velocity sync write"
                )

        result = self.group_sync_write_velocity.txPacket()
        if result != COMM_SUCCESS:
            self.get_logger().error(
                f"Velocity sync write failed: {self.packet_handler.getTxRxResult(result)}"
            )
            return

        for motor, goal_velocity in goal_velocities.items():
            self.last_goal_velocities[motor.id] = goal_velocity

    def _write1(self, dxl_id: int, address: int, value: int):
        result, error = self.packet_handler.write1ByteTxRx(
            self.port_handler, dxl_id, address, value
        )
        self._check_result(dxl_id, address, result, error)

    def _write2(self, dxl_id: int, address: int, value: int):
        result, error = self.packet_handler.write2ByteTxRx(
            self.port_handler, dxl_id, address, value
        )
        self._check_result(dxl_id, address, result, error)

    def _write4(self, dxl_id: int, address: int, value: int):
        result, error = self.packet_handler.write4ByteTxRx(
            self.port_handler, dxl_id, address, value
        )
        self._check_result(dxl_id, address, result, error)

    def _check_result(self, dxl_id: int, address: int, result: int, error: int):
        if result != COMM_SUCCESS:
            self.get_logger().error(
                f"DXL {dxl_id} write failed at {address}: "
                f"{self.packet_handler.getTxRxResult(result)}"
            )
        elif error != 0:
            self.get_logger().error(
                f"DXL {dxl_id} packet error at {address}: "
                f"{self.packet_handler.getRxPacketError(error)}"
            )


def main(args: Optional[List[str]] = None):
    rclpy.init(args=args)
    node = DxlJointStateBridge()
    try:
        rclpy.spin(node)
    except KeyboardInterrupt:
        pass
    finally:
        node.destroy_node()
        if rclpy.ok():
            rclpy.shutdown()


if __name__ == "__main__":
    main()
