alscjfdl33-pixel/biped_bike_runtime/(commit log)

2026-08-25 feat: create independent biped bike runtime package
    [arm_base_yaw.STL, arm_elbow_pitch.STL, arm_shoulder_pitch.STL, arm_wrist_pitch.STL, arm_wrist_roll.STL, base_link.STL, biped_bike_runtime.urdf, biped_bike_runtime_ver5.csv]
2026-08-25 Sync runtime with ver6 robot hardware
    [arm_base_yaw.STL, arm_elbow_pitch.STL, arm_shoulder_pitch.STL, arm_wrist_pitch.STL, arm_wrist_roll.STL, base_link.STL, biped_bike_robot_print_ver6.csv, biped_bike_robot_print_ver6.urdf]
2026-08-25 Make hardware bridge shutdown release torque safely
2026-09-05 Improve physical hardware runtime and bike visualization
    [biped_bike_runtime.urdf]
